crgmakes/aquarius-node-hw/pcb/interfaces.kicad_sch

## KiCad design pcb/interfaces.kicad_sch (2026-07-30)

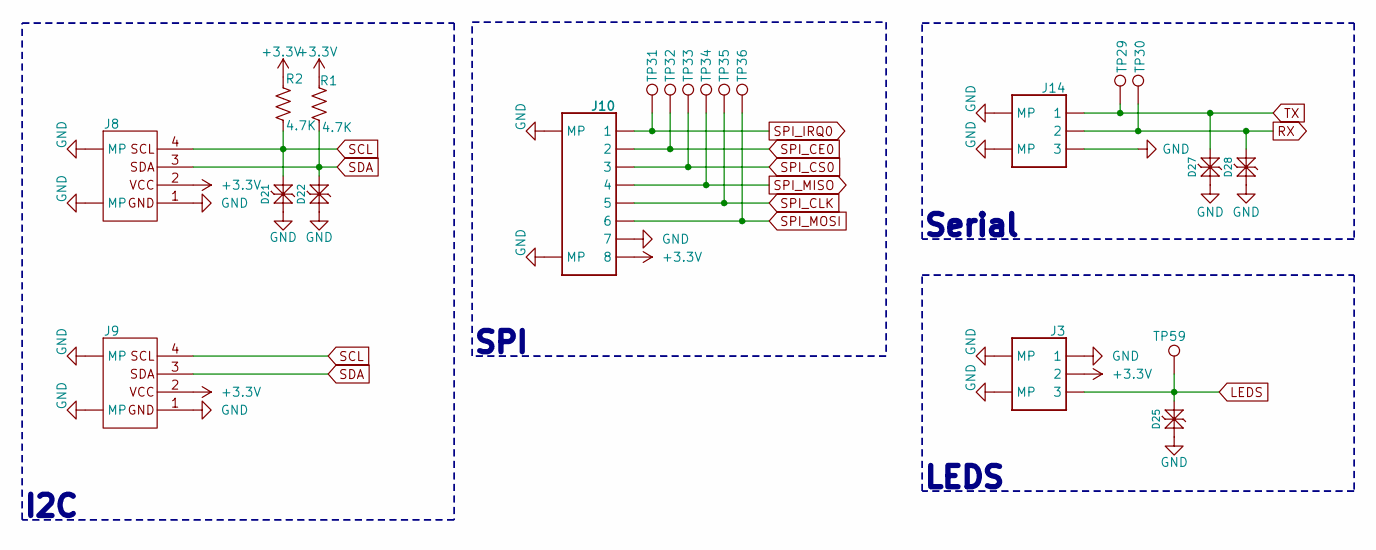
[picture p1: schematic interfaces.kicad_sch]

Parts:
D21, D22, D25, D27, D28: PESD3V3S1BL; DFN1006-2; MPN LESD8D3.3CAT5G; LCSC C5563754
J3, J14: JST_SH_BM03B-SRSS-TB_1x03-1MP_P1.00mm_Vertical; MPN BM03B-SRSS-TB; LCSC C2904985
J8, J9: JST_SH_BM04B-SRSS-TB_1x04-1MP_P1.00mm_Vertical; MPN BM04B-SRSS-TBT(LF)(SN); LCSC C2919601
J10: JST_SH_BM08B-SRSS-TB_1x08-1MP_P1.00mm_Vertical; MPN BM08B-SRSS-TB(LF)(SN); LCSC C2845376
R1, R2: 4.7K; R_0603_1608Metric; Tolerance 5%; MPN FRC0603J472 TS; Mouser 652-CR0603-JW-472ELF
TP29, TP30, TP31, TP32, TP33, TP34, TP35, TP36, TP59: TestPoint_Pad_D1.0mm

Connections:
+3.3V: J3.2, J8.2, J9.2, J10.8, R1.1, R2.1
GND: D21.1 (K1), D22.1 (K1), D25.1 (K1), D27.1 (K1), D28.1 (K1), J3.0 (MP), J3.1, J3.4 (MP), J8.0 (MP), J8.1, J8.5 (MP), J9.0 (MP), J9.1, J9.5 (MP), J10.0 (MP), J10.7, J10.9 (MP), J14.0 (MP), J14.3, J14.4 (MP)
LEDS: D25.2 (K2), J3.3, TP59.1
RX: D28.2 (K2), J14.2, TP30.1
SCL: D21.2 (K2), J8.4, J9.4, R2.2
SDA: D22.2 (K2), J8.3, J9.3, R1.2
SPI_CE0: J10.2, TP32.1
SPI_CLK: J10.5, TP35.1
SPI_CS0: J10.3, TP33.1
SPI_IRQ0: J10.1, TP31.1
SPI_MISO: J10.4, TP34.1
SPI_MOSI: J10.6, TP36.1
TX: D27.2 (K2), J14.1, TP29.1

Notes on the sheet:
LEDS
I2C
Serial
SPI
