crgmakes/aquarius-node-hw/pcb/mcu.kicad_sch

## KiCad design pcb/mcu.kicad_sch (2026-07-30)

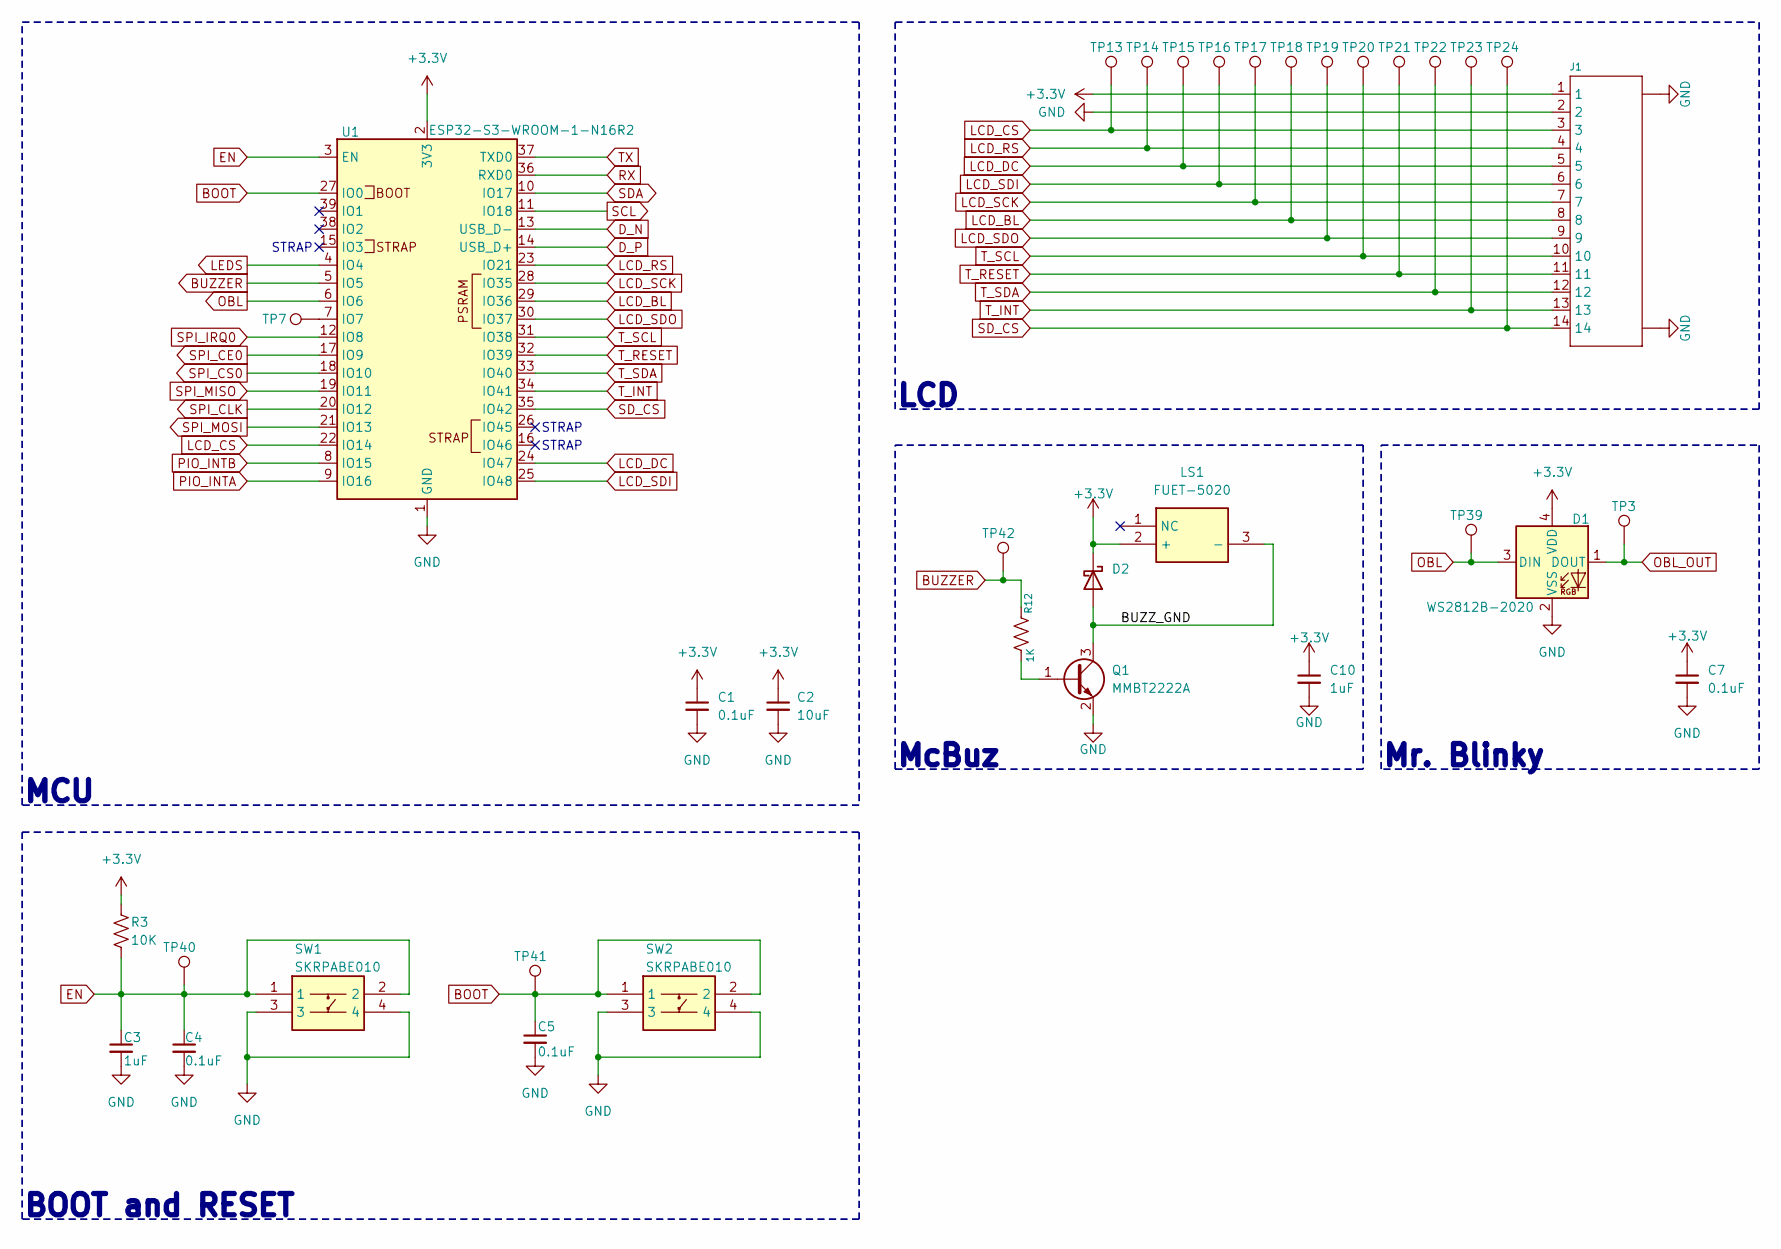
[picture p2: schematic mcu.kicad_sch]

Parts:
C1, C4, C7: 0.1uF; C_0603_1608Metric; Tolerance 10%; MPN CL10B104KO8NNNC; Mouser 187-CL10B104KO8NNNC
C2: 10uF; C_0603_1608Metric; Tolerance 10%; MPN CL10A106MO8NQNC; Mouser 187-CL10A106MO8NQNC
C3: 1uF; C_0603_1608Metric; Tolerance 10%; MPN CL10B105KO8NNNC; Mouser 187-CL10B105KO8NNNC
C5: 0.1uF; C_0603_1608Metric; Tolerance 10%; MPN CL10B104KO8NNNC; Digikey 1276-1005-2-ND
C10: 1uF; C_0603_1608Metric; Tolerance 10%; MPN CL10B105KO8NNNC; LCSC C6119849
D1: WS2812B-2020; LED_WS2812B-2020_PLCC4_2.0x2.0mm; MPN WS2812C-2020-V1; LCSC C2976072
D2: D_Schottky; D_SOD-523; MPN MSK4010; LCSC C345958
J1: XF2M-1415-1A; MPN XF2M-1415-1A; Mouser 653-XF2M-1415-1A
LS1: FUET-5020; FUET-5025; MPN FUET-5020; Mouser 490-CMT-0502-75SMTTR
Q1: MMBT2222A; SOT-523; MPN MMBT2222AT-7-F; Mouser 621-MMBT2222AT-F
R3: 10K; R_0603_1608Metric; Tolerance 5%; MPN FRC0603J103TS; Mouser 652-CR0603-JW-103ELF
R12: 1K; R_0603_1608Metric; Tolerance 5%; MPN FRC0603J102 TS; LCSC C2907113
SW1, SW2: SKRPABE010; SMD-4P-4.2x3.2mm; MPN SKRPABE010; Digikey 4809-SKRPABE010TR-ND
TP3, TP7, TP13, TP14, TP15, TP16, TP17, TP18, TP19, TP20, TP21, TP22, TP23, TP24, TP39, TP40, TP41, TP42: TestPoint_Pad_D1.0mm
U1: ESP32-S3-WROOM-1-N16R2; MPN ESP32-S3-WROOM-1-N16R2; Mouser 356-ESP32-S3WRM1N16R2

Connections:
+3.3V: C1.1, C2.1, C7.1, C10.1, D1.4 (VDD), D2.1 (K), J1.1, LS1.2 (+), R3.1, U1.2 (3V3)
BOOT: C5.1, SW2.1, SW2.2, TP41.1, U1.27 (IO0)
BUZZER: R12.1, TP42.1, U1.5 (IO5)
BUZZ_GND: D2.2 (A), LS1.3 (-), Q1.3 (C)
D_N: U1.13 (USB_D-)
D_P: U1.14 (USB_D+)
EN: C3.1, C4.1, R3.2, SW1.1, SW1.2, TP40.1, U1.3 (EN)
GND: C1.2, C2.2, C3.2, C4.2, C5.2, C7.2, C10.2, D1.2 (VSS), J1.0, J1.2, J1.15, Q1.2 (E), SW1.3, SW1.4, SW2.3, SW2.4, U1.1 (GND), U1.40 (GND), U1.41 (GND)
LCD_BL: J1.8, TP18.1, U1.29 (IO36)
LCD_CS: J1.3, TP13.1, U1.22 (IO14)
LCD_DC: J1.5, TP15.1, U1.24 (IO47)
LCD_RS: J1.4, TP14.1, U1.23 (IO21)
LCD_SCK: J1.7, TP17.1, U1.28 (IO35)
LCD_SDI: J1.6, TP16.1, U1.25 (IO48)
LCD_SDO: J1.9, TP19.1, U1.30 (IO37)
LEDS: U1.4 (IO4)
unnamed: Q1.1 (B), R12.2
unnamed: TP7.1, U1.7 (IO7)
OBL: D1.3 (DIN), TP39.1, U1.6 (IO6)
OBL_OUT: D1.1 (DOUT), TP3.1
PIO_INTA: U1.9 (IO16)
PIO_INTB: U1.8 (IO15)
RX: U1.36 (RXD0)
SCL: U1.11 (IO18)
SDA: U1.10 (IO17)
SD_CS: J1.14, TP24.1, U1.35 (IO42)
SPI_CE0: U1.17 (IO9)
SPI_CLK: U1.20 (IO12)
SPI_CS0: U1.18 (IO10)
SPI_IRQ0: U1.12 (IO8)
SPI_MISO: U1.19 (IO11)
SPI_MOSI: U1.21 (IO13)
TX: U1.37 (TXD0)
T_INT: J1.13, TP23.1, U1.34 (IO41)
T_RESET: J1.11, TP21.1, U1.32 (IO39)
T_SCL: J1.10, TP20.1, U1.31 (IO38)
T_SDA: J1.12, TP22.1, U1.33 (IO40)

Notes on the sheet:
McBuz
MCU
STRAP
BOOT and RESET
Mr. Blinky
LCD
