crgmakes/aquarius-node-hw/pcb/peripherals.kicad_sch

## KiCad design pcb/peripherals.kicad_sch (2026-07-30)

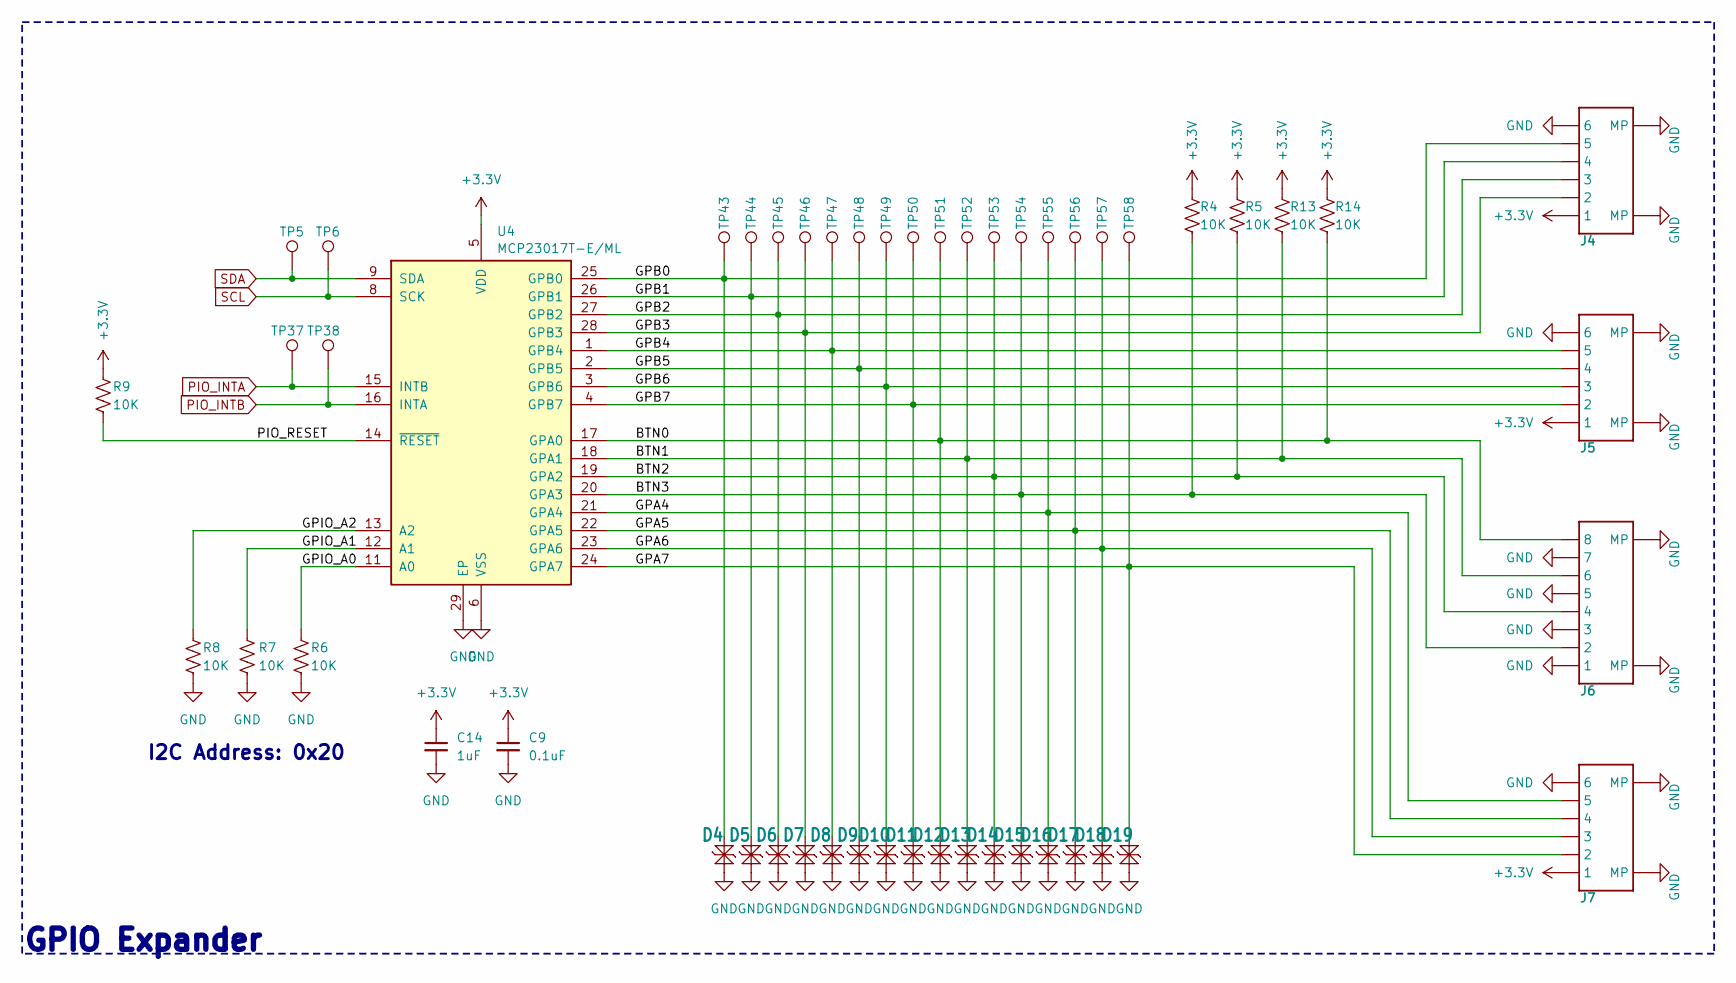
[picture p3: schematic peripherals.kicad_sch]

Parts:
C9: 0.1uF; C_0603_1608Metric; Tolerance 10%; MPN CL10B104KO8NNNC; LCSC C66501
C14: 1uF; C_0603_1608Metric; Tolerance 10%; MPN CL10B105KO8NNNC; LCSC C6119849
D4, D5, D6, D7, D8, D9, D10, D11, D12, D13, D14, D15, D16, D17, D18, D19: PESD3V3S1BL; DFN1006-2; MPN LESD8D3.3CAT5G; LCSC C5563754
J4, J5, J7: JST_SH_BM06B-SRSS-TB_1x06-1MP_P1.00mm_Vertical; MPN BM06B-SRSS-TBT(LF)(SN); LCSC C2845374
J6: JST_SH_BM08B-SRSS-TB_1x08-1MP_P1.00mm_Vertical; MPN BM08B-SRSS-TB(LF)(SN); LCSC C2845376
R4, R5, R6, R7, R8, R9, R13, R14: 10K; R_0603_1608Metric; Tolerance 5%; MPN FRC0603J103TS; LCSC C2930027
TP5, TP6, TP37, TP38, TP43, TP44, TP45, TP46, TP47, TP48, TP49, TP50, TP51, TP52, TP53, TP54, TP55, TP56, TP57, TP58: TestPoint_Pad_D1.0mm
U4: MCP23017T-E/ML; QFN-28-1EP_6x6mm_P0.65mm_EP4.25x4.25mm; MPN MCP23017T-E/ML; LCSC C629439

Connections:
+3.3V: C9.1, C14.1, J4.1, J5.1, J7.1, R4.1, R5.1, R9.1, R13.1, R14.1, U4.5 (VDD)
BTN0: D12.2 (K2), J6.8, R14.2, TP51.1, U4.17 (GPA0)
BTN1: D13.2 (K2), J6.6, R13.2, TP52.1, U4.18 (GPA1)
BTN2: D14.2 (K2), J6.4, R5.2, TP53.1, U4.19 (GPA2)
BTN3: D15.2 (K2), J6.2, R4.2, TP54.1, U4.20 (GPA3)
GND: C9.2, C14.2, D4.1 (K1), D5.1 (K1), D6.1 (K1), D7.1 (K1), D8.1 (K1), D9.1 (K1), D10.1 (K1), D11.1 (K1), D12.1 (K1), D13.1 (K1), D14.1 (K1), D15.1 (K1), D16.1 (K1), D17.1 (K1), D18.1 (K1), D19.1 (K1), J4.0 (MP), J4.6, J4.7 (MP), J5.0 (MP), J5.6, J5.7 (MP), J6.0 (MP), J6.1, J6.3, J6.5, J6.7, J6.9 (MP), J7.0 (MP), J7.6, J7.7 (MP), R6.2, R7.2, R8.2, U4.6 (VSS), U4.29 (EP)
GPA4: D16.2 (K2), J7.5, TP55.1, U4.21 (GPA4)
GPA5: D17.2 (K2), J7.4, TP56.1, U4.22 (GPA5)
GPA6: D18.2 (K2), J7.3, TP57.1, U4.23 (GPA6)
GPA7: D19.2 (K2), J7.2, TP58.1, U4.24 (GPA7)
GPB0: D4.2 (K2), J4.5, TP43.1, U4.25 (GPB0)
GPB1: D5.2 (K2), J4.4, TP44.1, U4.26 (GPB1)
GPB2: D6.2 (K2), J4.3, TP45.1, U4.27 (GPB2)
GPB3: D7.2 (K2), J4.2, TP46.1, U4.28 (GPB3)
GPB4: D8.2 (K2), J5.5, TP47.1, U4.1 (GPB4)
GPB5: D9.2 (K2), J5.4, TP48.1, U4.2 (GPB5)
GPB6: D10.2 (K2), J5.3, TP49.1, U4.3 (GPB6)
GPB7: D11.2 (K2), J5.2, TP50.1, U4.4 (GPB7)
GPIO_A0: R6.1, U4.11 (A0)
GPIO_A1: R7.1, U4.12 (A1)
GPIO_A2: R8.1, U4.13 (A2)
PIO_INTA: TP37.1, U4.15 (INTB)
PIO_INTB: TP38.1, U4.16 (INTA)
PIO_RESET: R9.2, U4.14 (~RESET)
SCL: TP6.1, U4.8 (SCK)
SDA: TP5.1, U4.9 (SDA)

Notes on the sheet:
I2C Address: 0x20
GPIO Expander
