crgmakes/aquarius-node-hw/pcb/power.kicad_sch

## KiCad design pcb/power.kicad_sch (2026-07-30)

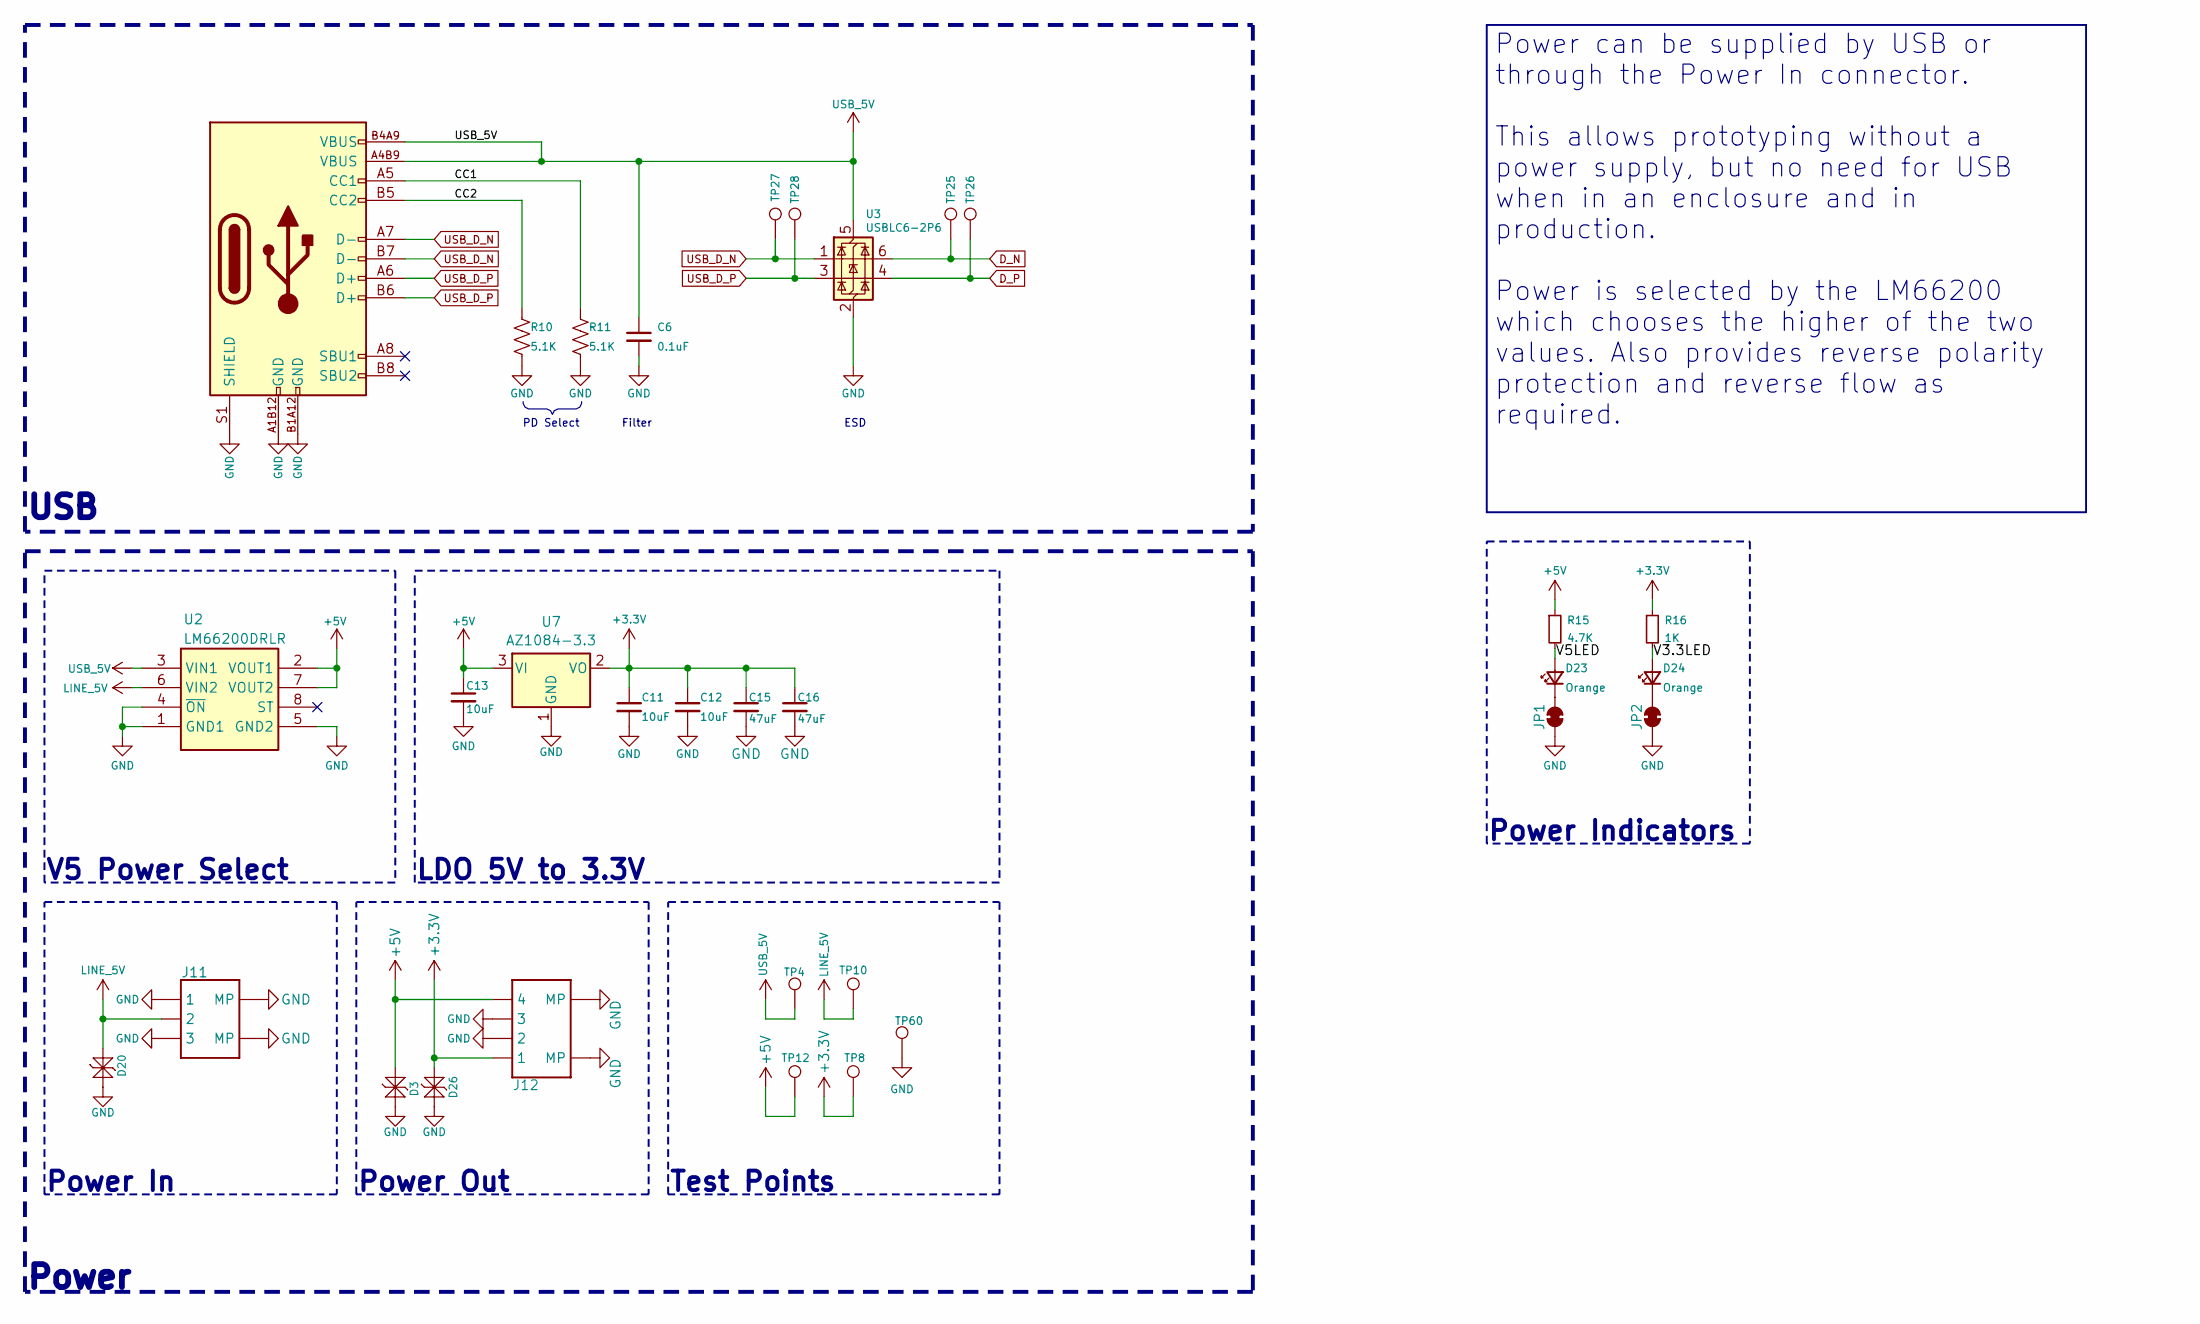
[picture p4: schematic power.kicad_sch]

Parts:
C6: 0.1uF; C_0603_1608Metric; Tolerance 10%; MPN CL10B104KO8NNNC; LCSC C66501
C11, C12, C13: 10uF; C_0603_1608Metric; Tolerance 10%; MPN CL10A106MO8NQNC; Mouser 187-CL10A106MO8NQNC
C15, C16: 47uF; C_0805_2012Metric; Tolerance 20%; MPN CL21A476MPYNNWE; LCSC C5596752
D3, D20: PESD5V5C1BL; DFN1006-2; MPN PESD5V5C1BLYL; LCSC C2827636
D23, D24: Orange; LED_0603_1608Metric; MPN XL-1608UOC-06; Mouser 859-LTST-C190KFKT
D26: PESD3V3S1BL; DFN1006-2; MPN LESD8D3.3CAT5G; LCSC C5563754
J2: USB_C_USB2.0_16P; GCT_USB4105-GF-A; MPN USB4105-GF-A-060; Mouser 640-USB4105-GF-A-060
J11: JST_SH_BM03B-SRSS-TB_1x03-1MP_P1.00mm_Vertical; MPN BM03B-SRSS-TB; LCSC C2904985
J12: JST_SH_BM04B-SRSS-TB_1x04-1MP_P1.00mm_Vertical; MPN BM04B-SRSS-TBT(LF)(SN); Mouser 306-BM04BSRSSTBTLFSN
JP1, JP2: SolderJumper-2_P1.3mm_Bridged_RoundedPad1.0x1.5mm
R10, R11: 5.1K; R_0603_1608Metric; Tolerance 5%; MPN FRC0603J512 TS; Mouser 652-CR0603JW-512ELF
R15: 4.7K; R_0603_1608Metric; Tolerance 5%; MPN FRC0603J472 TS; Mouser 652-CR0603-JW-472ELF
R16: 1K; R_0603_1608Metric; Tolerance 5%; MPN FRC0603J102 TS; Mouser 652-CR0603-JW-102ELF
TP4, TP8, TP10, TP12, TP25, TP26, TP27, TP28, TP60: TestPoint_Pad_D1.0mm
U2: LM66200DRLR; SOTFL50P160X60-8N; MPN LM66200DRLR; Mouser 595-LM66200DRLR
U3: USBLC6-2P6; SOT-666; MPN USBLC6-2P6; LCSC C2827693
U7: AZ1084-3.3; TO-252-2; MPN AZ1084CD-3.3TRG1; Mouser 621-AZ1084CD-3.3TRG1

Connections:
+3.3V: C11.1, C12.1, C15.1, C16.1, D26.2 (K2), J12.1, R16.1, TP8.1, U7.2 (VO)
+5V: C13.1, D3.2 (K2), J12.4, R15.1, TP12.1, U2.2 (VOUT1), U2.7 (VOUT2), U7.3 (VI)
CC1: J2.A5 (CC1), R11.1
CC2: J2.B5 (CC2), R10.1
D_N: TP25.1, U3.6 (I/O1)
D_P: TP26.1, U3.4 (I/O2)
GND: C6.2, C11.2, C12.2, C13.2, C15.2, C16.2, D3.1 (K1), D20.1 (K1), D26.1 (K1), J2.A1B12 (GND), J2.B1A12 (GND), J2.S1 (SHIELD), J11.0 (MP), J11.1, J11.3, J11.4 (MP), J12.0 (MP), J12.2, J12.3, J12.5 (MP), JP1.1 (A), JP2.1 (A), R10.2, R11.2, TP60.1, U2.1 (GND1), U2.4 (~ON), U2.5 (GND2), U3.2 (GND), U7.1 (GND)
LINE_5V: D20.2 (K2), J11.2, TP10.1, U2.6 (VIN2)
unnamed: D23.1 (K), JP1.2 (B)
unnamed: D24.1 (K), JP2.2 (B)
USB_5V: C6.1, J2.A4B9 (VBUS), J2.B4A9 (VBUS), TP4.1, U2.3 (VIN1), U3.5 (VBUS)
USB_D_N: J2.A7 (D-), J2.B7 (D-), TP27.1, U3.1 (I/O1)
USB_D_P: J2.A6 (D+), J2.B6 (D+), TP28.1, U3.3 (I/O2)
V3.3LED: D24.2 (A), R16.2
V5LED: D23.2 (A), R15.2

Notes on the sheet:
Test Points
Power Indicators
Power In
USB
Filter
PD Select
LDO 5V to 3.3V
ESD
V5 Power Select
Power
Power Out
Power can be supplied by USB or through the Power In connector. This allows prototyping without a power supply, but no need for USB when in an enclosure and in production. Power is selected by the LM66200 which chooses the higher of the two values. Also provides reverse polarity protection and reve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
