crgmakes/aquarius-node-hw/pcb/requirements.kicad_sch

## KiCad design pcb/requirements.kicad_sch (2026-07-30)

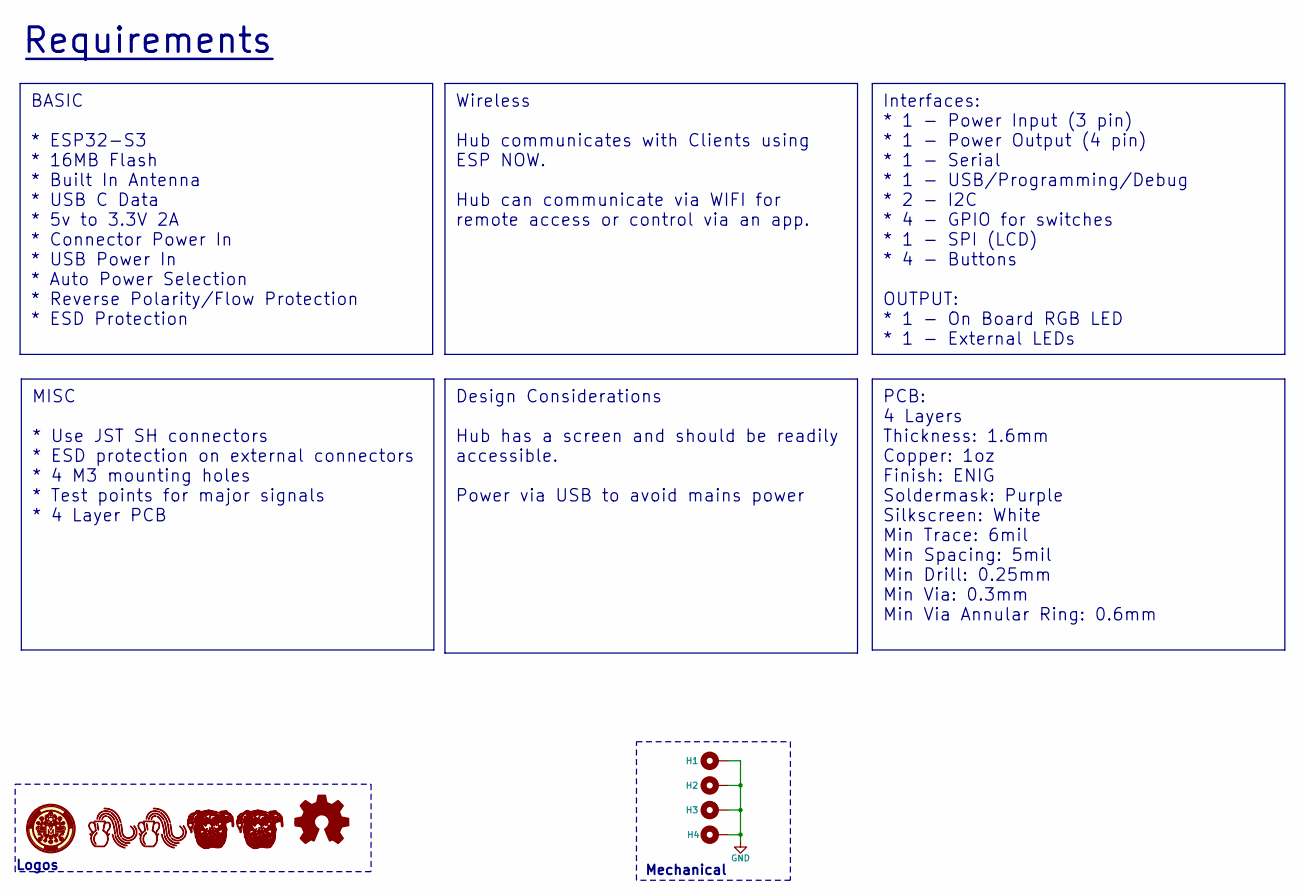
[picture p5: schematic requirements.kicad_sch]

Parts:
H1, H2, H3, H4: MountingHole_3.2mm_M3_Pad_Via
LOGO1: CRGM Logo 7mm
LOGO2: Aquarius Logo 8mm
LOGO3: OSHW-Logo_5.7x6mm_SilkScreen
LOGO4: Aquarius Logo 3.5mm
LOGO5: Roxy 5mm
LOGO6: Roxy 8mm

Connections:
GND: H1.1, H2.1, H3.1, H4.1

Notes on the sheet:
Mechanical
Requirements
Logos
Design Considerations Hub has a screen and should be readily accessible. Power via USB to avoid mains power
BASIC * ESP32-S3 * 16MB Flash * Built In Antenna * USB C Data * 5v to 3.3V 2A * Connector Power In * USB Power In * Auto Power Selection * Reverse Polarity/Flow Protection * ESD Protection
MISC * Use JST SH connectors * ESD protection on external connectors * 4 M3 mounting holes * Test points for major signals * 4 Layer PCB
Wireless Hub communicates with Clients using ESP NOW. Hub can communicate via WIFI for remote access or control via an app.
PCB: 4 Layers Thickness: 1.6mm Copper: 1oz Finish: ENIG Soldermask: Purple Silkscreen: White Min Trace: 6mil Min Spacing: 5mil Min Drill: 0.25mm Min Via: 0.3mm Min Via Annular Ring: 0.6mm
Interfaces: * 1 - Power Input (3 pin) * 1 - Power Output (4 pin) * 1 - Serial * 1 - USB/Programming/Debug * 2 - I2C * 4 - GPIO for switches * 1 - SPI (LCD) * 4 - Buttons OUTPUT: * 1 - On Board RGB LED * 1 - External LEDs
