crgmakes/aquarius-node-hw/(commit log)

2026-07-30 Renamed and added guard ring
    [aquarius-hub-hw.xlsx, aquarius-node-hw.kicad_sch, interfaces.kicad_sch, mcu.kicad_sch, peripherals.kicad_sch, power.kicad_sch, requirements.kicad_sch]
2026-07-30 Clean up; ERC and DRC.
    [mcu.kicad_sch]
2026-07-30 Updated readme and minor silkscreen changes
2026-07-30 minor silkscreen changes
    moved MRB a little.
2026-07-30 Fixed CI script after name change
    Updated PCB from sch
2026-07-30 Fixed TO-252 package
    Adjusted silkscreen.
2026-07-31 DFM updates to board and footprints
2026-07-31 Changed corner fillet to 3mm
    minor silkscreen changes
    updated renders
    [aquarius-node-hw.kicad_sch]
2026-08-01 Clean up
    [aquarius-node-hw.kicad_sch]
